David-Hari/Bicycle-Monitor/gear_shifter/circuit diagram.bmp

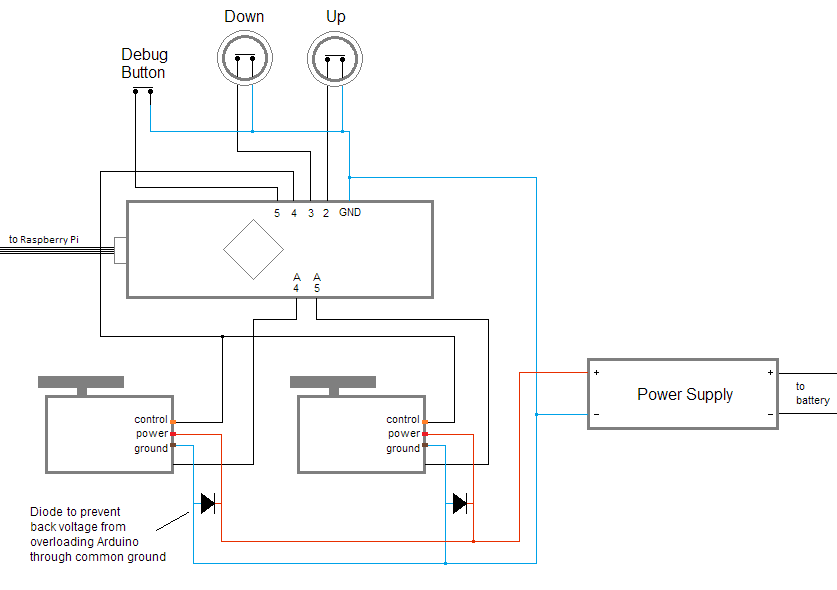
gear_shifter/circuit diagram.bmp
