David-Hari/Bicycle-Monitor/logo.dxf

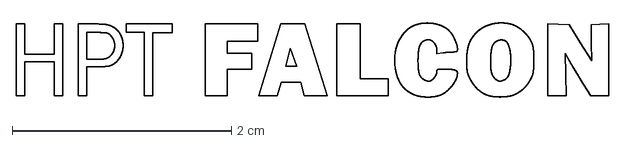
[picture p2: CAD file, 2019-11-21]
logo.dxf
5.40 x 0.676 cm
