David-Hari/Bicycle-Monitor/gear_shifter/servo_control.ino

#include "servo_control.h"


// Servo wires colours
//---------------------
// Brown  =  Ground
// Red    =  Power Supply
// Orange =  Control Signal


const int SERVO_MIN_ANGLE = 0;    // Degrees
const int SERVO_MAX_ANGLE = 172;
const int SERVO_MIN_PULSE = 500;  // Microseconds
const int SERVO_MAX_PULSE = 2500;

// Range of analog input from potentiometer.
// The full range of analog read is 0-1023, but it's less here because the max voltage is less than 5V.
// I actually measured a wider range when moving it by hand (21 (0.112V) to 649 (3.130V))
// but this is what the servo can actually do when sent the min/max pulses.
// Also note that the numbers are reversed, with the largest number representing 0 degrees.
const int ANALOG_MIN = 620;   // SERVO_MIN_ANGLE.
const int ANALOG_MAX = 60;    // SERVO_MAX_ANGLE.

Servo servo;


/*************************************************************************/
/* Start sending pulses to the servo to control it.                      */
/*************************************************************************/
void initializeServo() {
	servo.attach(SERVO_PIN, SERVO_MIN_PULSE, SERVO_MAX_PULSE);
}


/*************************************************************************/
/* Stop sending pulses to the servo. This SHOULD turn off the servo and  */
/* make it "limp", but it does not. Perhaps this brand holds even when   */
/* PWM signal stops.                                                     */
/*************************************************************************/
void stopServo() {
	servo.detach();
}


/*************************************************************************/
/* Read the current position of the servo at the given pin, averaging it */
/* over a number of reads to avoid noise.                                */
/*************************************************************************/
int readAngle(int pin) {
	int value = 0;
	const int NUM_READS = 5;
	for (int i = 0; i < NUM_READS; i++) {
		delay(10);
		value += analogRead(pin);
	}
	int average = value / NUM_READS;
	return map(average, ANALOG_MIN, ANALOG_MAX, SERVO_MIN_ANGLE, SERVO_MAX_ANGLE);
}
int readAngle1() {
	return readAngle(FEEDBACK_PIN_1);
}
int readAngle2() {
	return readAngle(FEEDBACK_PIN_2);
}


/*************************************************************************/
/* Return the gear that corresponds to the given angle, or -1 if the     */
/* angle is not aligned to any gear.                                     */
/*************************************************************************/
int getGearAtPosition(int angle) {
	for (int i = 0; i < MAX_GEARS; i++) {
		int gearAngle = gearPositions[i];
		if (angle >= gearAngle - READ_ANGLE_THRESHOLD && angle <= gearAngle + READ_ANGLE_THRESHOLD) {
			return i + 1;
		}
	}
	return -1;
}


/*************************************************************************/
/* Return the currently selected gear.                                   */
/* Error if the servo position does not correspond to any gear.          */
/*************************************************************************/
int readGear() {
	int angle1 = readAngle1();
	int angle2 = readAngle2();
	if (abs(angle1 - angle2) > ALIGNMENT_THRESHOLD) {
		reportError("Servo motors not aligned. Motor 1: " + String(angle1) + "°, Motor 2: " + String(angle2) + "°");
		return -1;
	}
	int currentGear = getGearAtPosition(angle1);
	if (currentGear < 0) {
		reportError("Gear not in correct position. Motor 1: " + String(angle1) + "°, Motor 2: " + String(angle2) + "°");
		return -1;
	}
	return currentGear;
}


/*************************************************************************/
/* Move the servo motor to the <toGear> position.                        */
/* Return true on success and false on error.                            */
/* Error if the two motors are not in the same position at the end.      */
/*************************************************************************/
boolean moveToGear(int toGear) {
	int currentAngle1, currentAngle2, newAngle;
	int currentGear = readGear();
	if (currentGear < 0) {
		reportError("Cannot move to gear " + String(toGear));
		return false;
	}

	// Incrementally move the servo motors with delays in between to control their speed
	currentAngle1 = gearPositions[currentGear-1];
	newAngle = gearPositions[toGear-1];
	moveServoSlowly(currentAngle1, newAngle, GEAR_CHANGE_DELAY);

	// Wait for servos to finish moving.
	long startWaitTime = millis();
	boolean isFinished1 = false;
	boolean isFinished2 = false;
	do {
		currentAngle1 = readAngle1();
		currentAngle2 = readAngle2();
		isFinished1 = currentAngle1 >= newAngle - MOVE_ANGLE_THRESHOLD && currentAngle1 <= newAngle + MOVE_ANGLE_THRESHOLD;
		isFinished2 = currentAngle2 >= newAngle - MOVE_ANGLE_THRESHOLD && currentAngle2 <= newAngle + MOVE_ANGLE_THRESHOLD;
	} while ((!isFinished1 || !isFinished2) && millis() - startWaitTime < GEAR_CHANGE_WAIT_TIME);

	// Error if one or both servos are still not at the correct angle after waiting.
	if (!isFinished1 || !isFinished2) {
		reportError("Servo motors didn't move to gear " + String(toGear) + ". Motor 1: " + String(currentAngle1) + "°, Motor 2: " + String(currentAngle2) + "°");
		return false;
	}

	return true;
}


/*************************************************************************/
/* For debug purposes only!                                              */
/* Finds the gear angle closest to the servos current angles then moves  */
/* them to that gear. If servos are already at a gear position then      */
/* there is no change.                                                   */
/* Returns the gear that the servos should now be at.                    */
/*************************************************************************/
int moveToNearestGear() {
	int currentAngle = readAngle1();

	int oldGearAngle = gearPositions[0];
	for (int i = 1; i < MAX_GEARS; i++) {
		int newGearAngle = gearPositions[i];
		int halfWay = (newGearAngle + oldGearAngle) / 2;
		if (currentAngle < halfWay) {
			moveServoSlowly(currentAngle, oldGearAngle, GEAR_CHANGE_DELAY);
			return i;   // Previous gear (i is zero based so no need to subtract 1)
		}
		else if (currentAngle >= halfWay && currentAngle <= newGearAngle) {
			moveServoSlowly(currentAngle, newGearAngle, GEAR_CHANGE_DELAY);
			return i + 1;
		}
		oldGearAngle = newGearAngle;
	}

	// If it gets to here then the angle must be greater than the highest gear
	return MAX_GEARS;
}


/*************************************************************************/
/* Move the servo motor to the given angle.                              */
/*************************************************************************/
void moveServo(int angle) {
	servo.writeMicroseconds(map(clampAngle(angle), SERVO_MIN_ANGLE, SERVO_MAX_ANGLE, SERVO_MIN_PULSE, SERVO_MAX_PULSE));
}


/*************************************************************************/
/* Move the servo motor slowly (one degree at a time) from the initial   */
/* angle to the final angle, with the given delay between each movement. */
/*************************************************************************/
void moveServoSlowly(int startAngle, int endAngle, int moveDelay) {
	if (endAngle >= startAngle) {
		for (int angle = startAngle; angle <= endAngle; angle++) {
			moveServo(angle);
			delay(moveDelay);
		}
	}
	else {
		for (int angle = startAngle; angle >= endAngle; angle--) {
			moveServo(angle);
			delay(moveDelay);
		}
	}
}


/*************************************************************************/
/* Clamp the given angle to within the range the servo can do.           */
/*************************************************************************/
int clampAngle(int angle) {
	return constrain(angle, 0, SERVO_MAX_ANGLE);
}
