David-Hari/Bicycle-Monitor/config.py

# Resolution of the display device (not the resolution that the camera is capturing at).
videoDisplayResolution = (1920, 1080)

# Channel IDs for each paired device. Set to None to enable searching.
heartRatePairing = (18029, 120, 1)
powerPairing = (2920, 11, 5)

# Bike parameters.
crankLength = 140.0 # mm

# Power output to try to achieve.
powerGoal = 270 # Watts

# Latitude and longitude of finish line. Used to calculate distance.
finishPosition = (40.4676639, -117.06286)
