David-Hari/Bicycle-Monitor/(commit log)

2019-05-03 Comment about camera
2019-05-05 Adding ability to log and display CPU temperature.
2019-05-14 Set camera sensor mode correctly to provide higher framerate & lower latency.
    [config.py, display.py, main.py]
2019-05-18 Use info.hspeed rather than info.speed(), as the error is often very large and causes speed() to always return 0.
    [main.py]
2019-05-20 Monkey patching PiCamera to try and silence "no buffers available" error. Taken from https://github.com/dtreskunov/rpi-sensorium/commit/40c6f3646931bf0735c5fe4579fa89947e96aed7.
    [display.py]
2019-05-20 Refined power graph.
2019-05-22 Refinements to power graph.
2019-05-25 Pedal differentiation flag no longer used.
    [data_logging.py, main.py]
2019-06-04 Minor changes to power bar overlay. Preparing for gps and heart-rate overlays.
2019-06-04 Added title to power overlay.
2019-06-11 Flip the camera image, as the top camera is mounted upside down.
    [display.py]
2019-06-23 Need to flip horizontally *and* vertically.
    [display.py]
2019-06-28 Added 3D model of platform to hold the two Raspberry Pi's to the bike.
    [pi holder.f3d]
2019-07-04 More work on it
    [pi holder.f3d]
2019-07-06 Pi holder is done.
    [pi holder.f3d]
2019-07-11 Don't need this any more.
    [pi holder.f3d]
2019-08-04 Removed print statements.
2019-08-10 Write logs to separate directories named with the current date/time, so they are not overwritten when the program starts up again.
2019-09-12 Use unique numbers for data directories instead of timestamp, due to date not always being correct.
    [data_logging.py]
2019-09-25 No need for temperature logging any more.
2019-09-26 Added logo sketch.
    [logo.dxf]
2019-09-29 Avoid error when data directory already exists.
    [data_logging.py]
2019-10-03 Increased search time-out when connecting to ANT devices. Also print more messages to stdout.
2019-10-10 Initial Arduino code for the gear shifter.
2019-10-16 Playing around with interrupts. The code works, but need to de-bounce the button input on both down (press) and up (release). Probably best to attach interrupt on CHANGE instead of just FALLING.
2019-10-17 Changed from interrupts to polling button state. It works as long as the delay in the main loop is long enough.
2019-10-19 Split code up into multiple files. Got both buttons and servo working.
2019-10-20 Move servo slower by adding a delay between each degree of movement.
2019-10-24 Improved how button presses are detected to make it responsive but also do de-bouncing.
2019-10-31 Start working on servo feedback.
2019-11-07 Almost got it working. But it still doesn't move to correct gear position.
    [buttons.ino, gear_shifter.h, gear_shifter.ino, servo_control.ino]
2019-11-17 Got initial reading of gear position working.
2019-11-21 Did some work on logo.
    [logo.dxf]
2019-11-21 Close ANT+ devices before exiting. This might fix the occasional startup problems.
    [main.py]
2019-12-26 Removed "gear changing" serial notification. Increased wait time when gear is changing, to prevent error when verifying gear.
    [gear_shifter.h, gear_shifter.ino, servo_control.ino]
2019-12-26 Added serial communication with Arduino gear changer. Also moved picamera patch code back into a function.
2019-12-27 Prevent "dictionary changed size during iteration" error in display.py by using a lock when accessing or updating statusOverlays.
    [display.py]
2019-12-27 Show gear number on screen. W.I.P.
2019-12-30 Gear shifter now fully working with Raspberry Pi.
2020-05-07 Slightly different way of reading CPU temperature.
2020-11-01 Read position of both servos and error if they are not the same. W.I.P.
    [gear_shifter.h, gear_shifter.ino, servo_control.ino]
2020-11-01 * Fixed copy paste error. * Enabled angle diff code. * Increased movement speed.
    [gear_shifter.h, servo_control.ino]
2020-11-09 Re-named variable to avoid confusion.
    [servo_control.ino]
2020-12-22 Added circuit diagram and comment about server wire colours.
2020-12-25 Updated circuit diagram.
2020-12-26 Changed number of gears and their positions.
2020-12-29 Increased button de-bounce delay from 100ms to 200ms.
2020-12-29 Defined MAX_GEARS as the actual number in the gear array, rather than just relying on a compile time assertion.
2020-12-29 Set de-bounce delay back to 100ms.
2020-12-29 Changed how errors are reported, to allow messages to include variables at the time of the error. Changed when angle difference is detected, although it still needs work.
    [gear_shifter.h, gear_shifter.ino, main.py, servo_control.ino]
2021-01-02 On start-up, wait for message from serial port (e.g. sent by the Raspberry Pi) or until both buttons are pushed. Better way of waiting until servos have finished moving.
2021-01-16 Reduced gear change speed. Slower is better.
2021-01-16 Yet another attempt at checking alignment of servos after moving. I think this should work best.
2021-01-16 In debug mode, errors do not stop the program.
    [gear_shifter.ino]
2021-02-01 Added a function for debugging that moves the servos to the closest gear position if they are out of alignment.
2021-02-01 Removed "TODO" from note about diodes.
2021-02-11 Read both servo positions when getting current gear, and check if they are aligned. This should prevent a disconnected feedback wire from fooling the code into thinking it's at the wrong gear (unles 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
    [gear_shifter.h, gear_shifter.ino, servo_control.ino]
2021-09-29 No need to flip any more, as both cameras will be right way up.
    [main.py]
2021-09-29 Send message type for all gear messages.
2021-10-02 * Changed how Python code reads data from Arduino (and use utf-8 strings instead of ascii). * Moved TODOs from notes to code files.
2021-10-03 Print gear error message instead of entire line.
    [main.py]
2021-10-30 Made header files for each ino file rather than putting all definitions in one. I was hoping this would make it easier to have a second "main" file for testing/debug, but this is still difficult with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
2021-10-30 Added debug code to constantly read and display gear servo position.
2021-10-30 Consider threshold when checking if servos are aligned.
2021-10-31 Fixed numbering of directories for recording.
    [recording.py]
2021-10-31 Updated gear positions.
2021-11-12 Changed button event handling in gear shifter and allowed it to receive shutdown message in the main loop. This should prevent servos from jumping around when power is cut, as it stops sending them s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
    [buttons.h, buttons.ino, common.h, gear_shifter.ino, main.py]
2021-11-13 Swapped buttons and gear direction.
    [buttons.h, servo_control.h]
2021-11-13 Swapped buttons back as they were correct. It was only the direction of the gears that needed changing.
    [buttons.h]
2021-11-19 Write to log file in recording directory instead of to console. The console was redirected to a log file when running as a service, but it didn't seem to keep logs from previous run.
    [main.py, recording.py]
2021-11-19 Have gear shifter send an acknowledge message after receiving shutdown message, so it can be logged and I can make sure it was received.
2021-11-20 Read from gear shifter after sending shutdown message, to get acknowledge response.
2021-11-21 Fixed log format. Added some more logging at shutdown.
    [main.py, recording.py]
2023-07-02 Added lines indicating that Arduino is connected to Raspberry Pi.
2023-07-03 Added test/debug code to control motor angle using the buttons, to finely adjust the angle when setting up gear positions.
2023-07-03 Change gear number display grey when in the process of changing gears.
2023-07-06 Added key bindings to change values.
    [test_display.py]
2023-07-06 Adjust position of gear number text.
2023-07-09 In adjust mode, implemented fast repeat rate after initial delay when pressing buttons.
2023-07-09 Fixed repeat rate by making a separate button check function that does not use debounce delay.
    [buttons.h, buttons.ino, gear_shifter.ino, servo_control.ino]
2023-07-09 Removed bar from power display and instead just show current power in large text.
2023-07-10 Properly fixed repeat rate by directly checking if the buttons are pressed instead of using the "checkInput" function which keeps track of when the button is released.
    [buttons.h, buttons.ino, gear_shifter.ino]
2023-07-12 * Changed error handling so it does not stop operation but instead just reports the error. * When not handling input, it will check to make sure the servos are still aligned. * Button debounce code w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
    [buttons.ino, common.h, gear_shifter.ino, servo_control.ino]
2023-07-12 Flipped direction of servo when adjusting using up/down buttons.
    [gear_shifter.ino]
2023-07-12 New gear positions.
2023-07-17 Removed type hint as it does not work on the Raspberry Pi.
    [main.py]
2023-07-19 Check gear on start up and don't start servos if something is wrong.
    [gear_shifter.ino]
2023-07-23 Add delays when detecting invalid gear on startup, to give messages time to be seen.
2023-07-29 Test message display (although it doesn't handle multiple messages on screen)
    [test_display.py]
2023-08-04 Read GPIO shutdown pin in main loop to give more control over when to shut down, allowing it to be aborted if an error occurs.
    [display.py, main.py]
2023-08-05 Added note about button.
2023-08-05 Allow it to start even if camera is not connected. Fixed bug with detecting shutdown button.
    [display.py, main.py]
2024-04-06 Don't send "Unexpected gear change" error if it occurred due to another error in readGear(), as we want the original error to be displayed and not overwritten.
    [gear_shifter.ino]
2024-04-08 Changed video recording to use key frames, as it should make playback better. Instead set bitrate to limit file size.
2024-05-19 Removed need to hold down both up/down buttons to enter debug mode, instead using the dedicated button on pin 5. Combined read and adjust loops into one loop, a single debug mode where you can adjust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
2024-05-19 Use finer angle threshold for determining if both servos are at same angle. Used different thresholds when reading servo angle and when waiting for servos to move to a gear. We want the move to be mo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
2024-05-21 More error handling when servos do not move to the next gear.
    [gear_shifter.ino, servo_control.h]
2024-06-17 Increased servo angle thresholds as it still sometimes thinks it's not in gear when it actually is. Also changed error message to be clearer about what happened.
    [servo_control.h, servo_control.ino]
2024-06-18 Refactored servo moving code so it can be used by the debug function (even though it's not used at the moment).
2024-08-05 Allow forcing servos to nearest gear when debug button is pressed.
2024-09-07 Check gear multiple times on startup because sometimes servo angles are inaccurate and force it into debug mode when it shouldn't be.
2024-09-11 Made speed and gear number larger and at the bottom of the screen. Removed power and heart rate from display. Replaced recordclass with regular Python class to avoid dependency on MSVC++.
    [display.py, main.py]
